tomrodinger/Raspberry_Pi_HAT_RS485/Pictures/view1.jpg

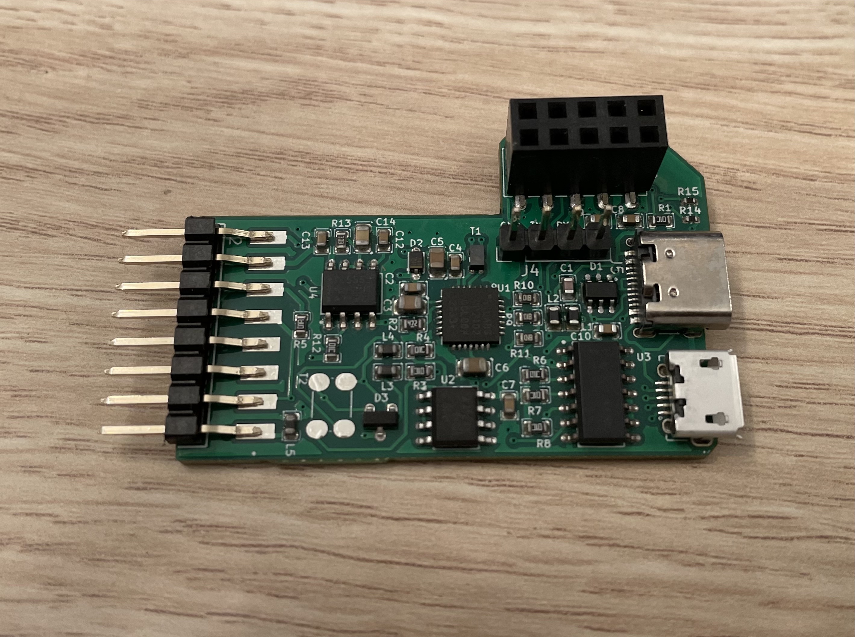
Pictures/view1.jpg
