tomrodinger/Raspberry_Pi_HAT_RS485/README.md

# Raspberry_Pi_HAT_RS485
This is a Raspberry Pi HAT for RS485 communication with external devices and it should fit into any Raspberry Pi like Zero/Zero2W/3/4
