tomrodinger/Raspberry_Pi_HAT_RS485/PCB/1.2/schematic/1.2-index-schTop.pdf

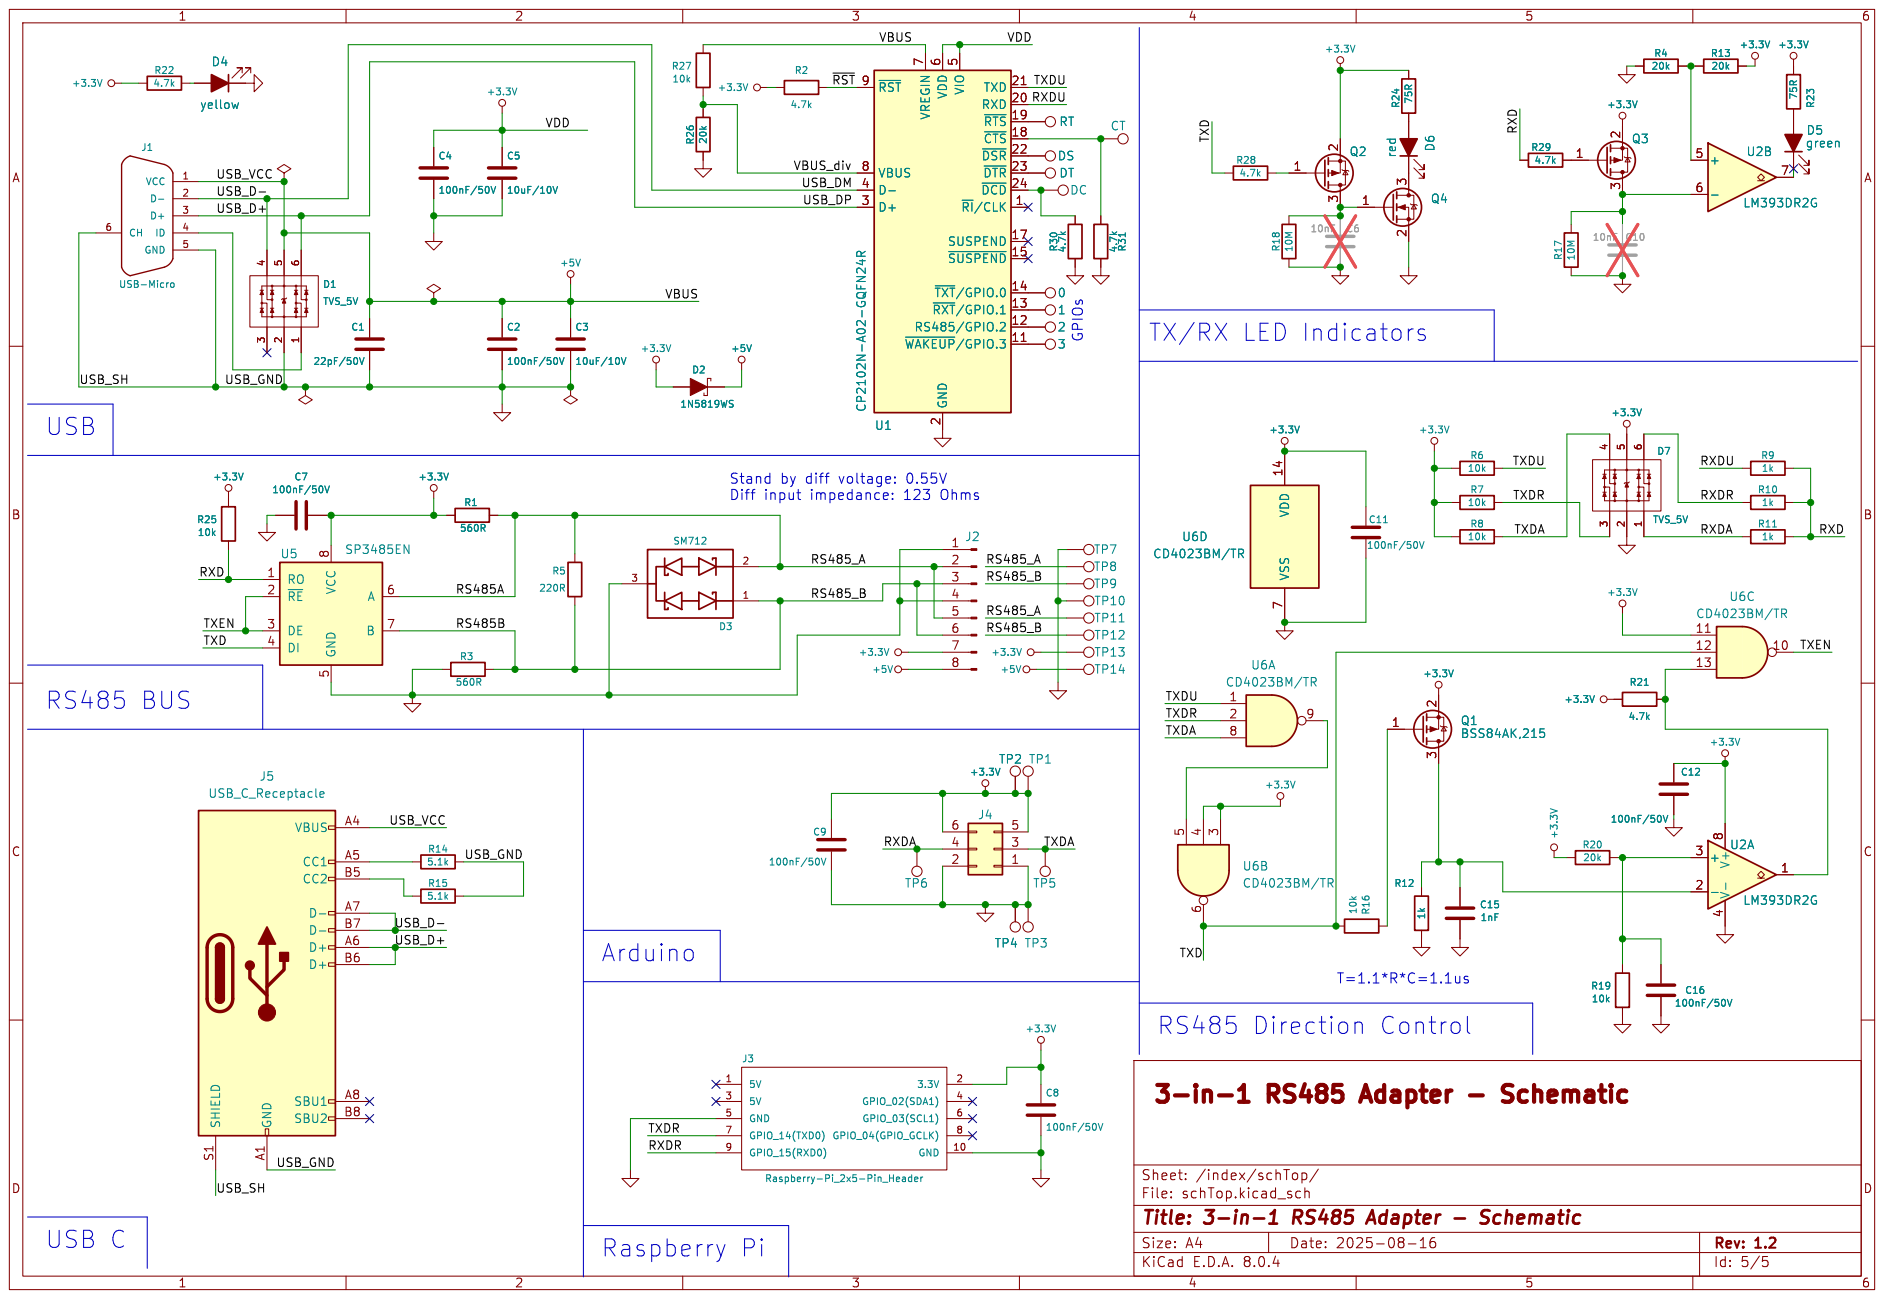
[picture p2: page 1]

2 RXD 20 TXD 21 ~{DSR} 22 ~{DTR} 23 ~{DCD} 24 D+ 3 D- 4 VIO

TX/RX LED Indicators

File: schTop.kicad_sch Sheet: /index/schTop/
