tomrodinger/Raspberry_Pi_HAT_RS485/PCB/1.1/schematic/1.1-index-schTop.pdf

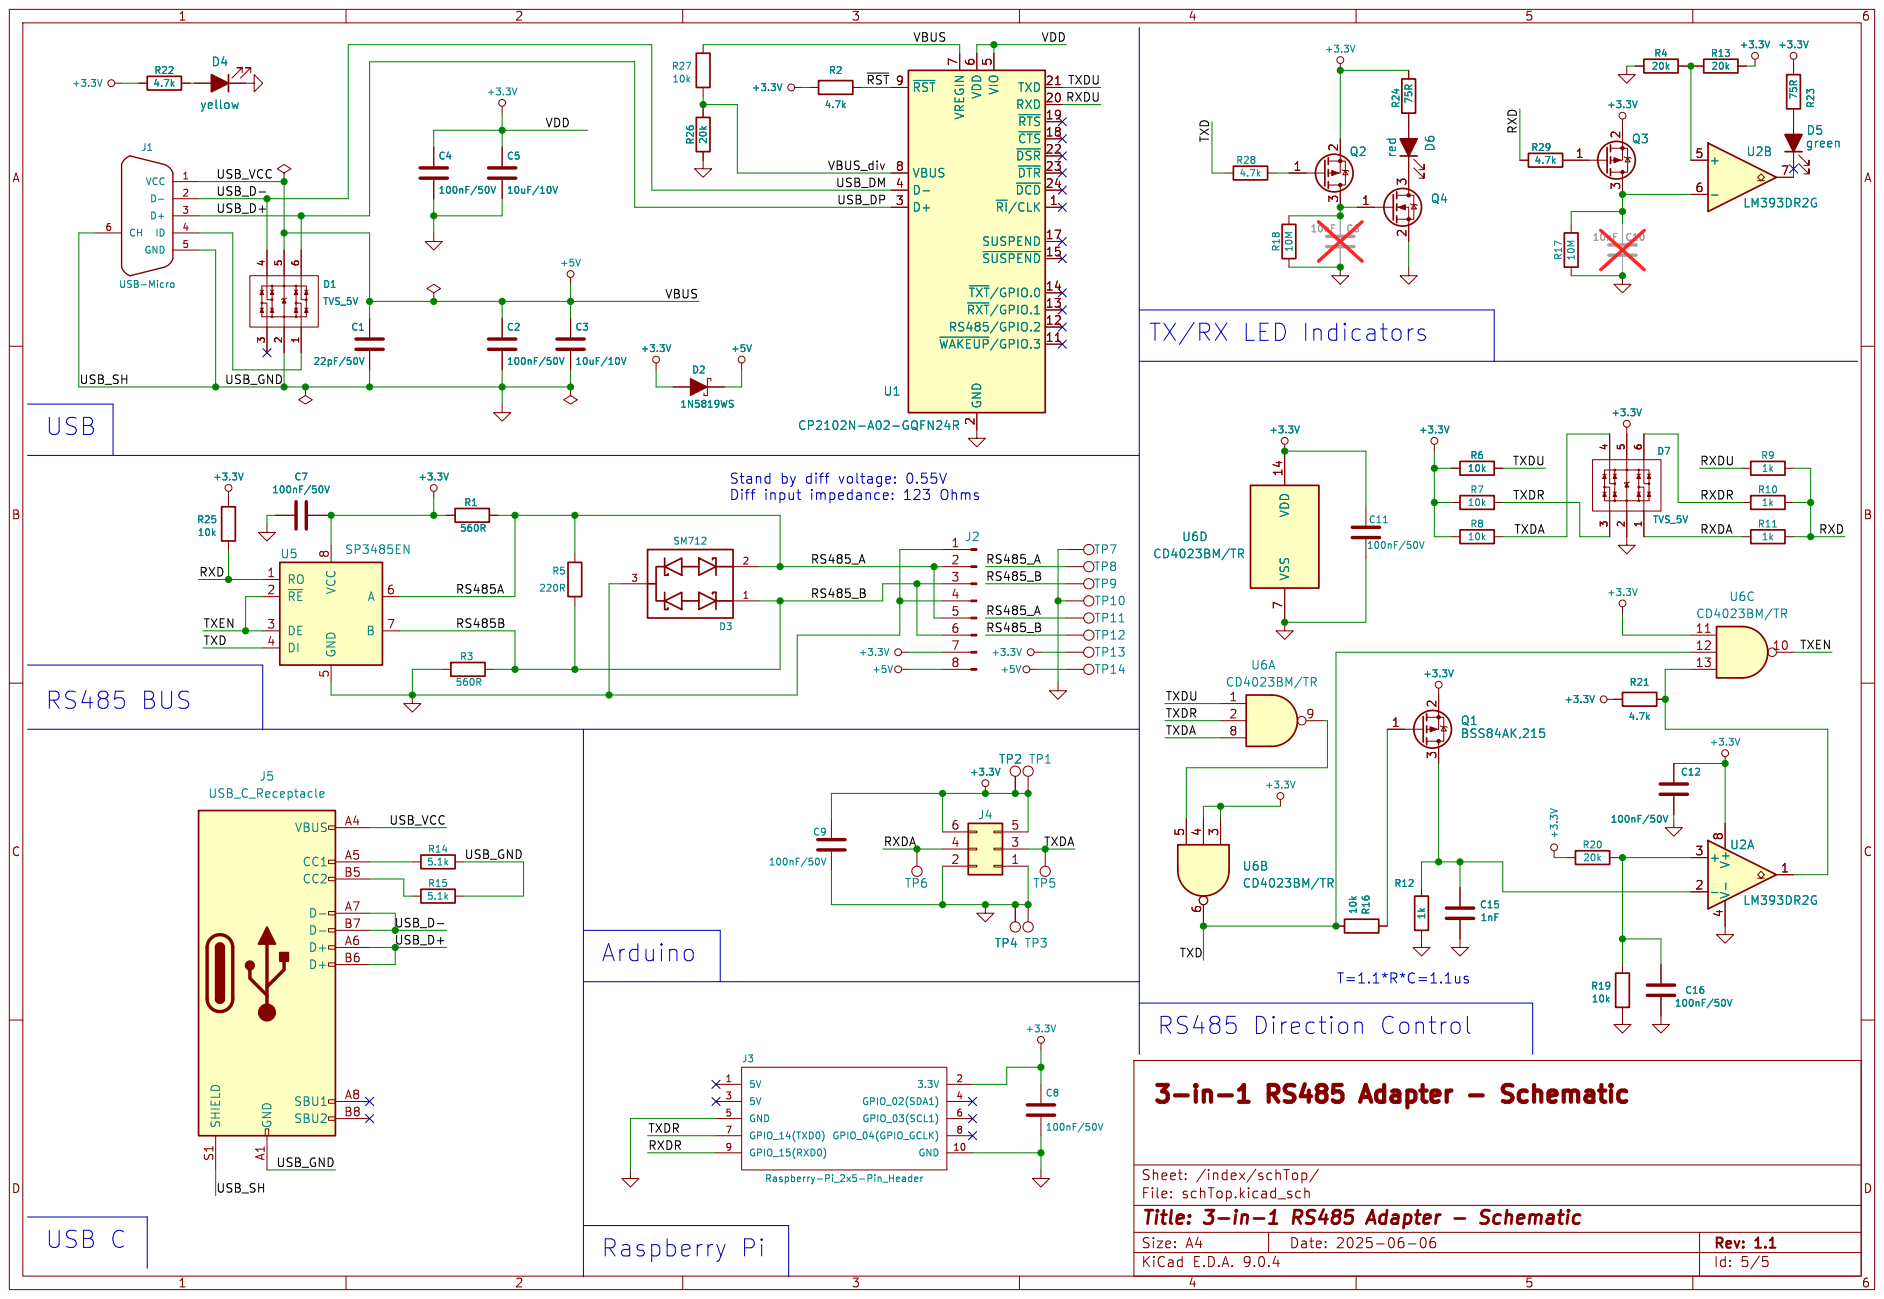
[picture p3: page 1]

5 TXD 21 RXD 20 ~{RTS} 19 ~{CTS} 18 ~{DSR} 22 ~{DTR} 23 ~{DCD} 24 ~{RI}/CLK1 SUSPEND 17 ~{SUSPEND}15 ~{TXT}/GPIO.014 ~{RXT}/GPIO.113 RS485/GPIO.2 12 ~{WAKEUP}/GPIO.311 U1 CP2102N-A02-GQFN24R

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
