tomrodinger/Raspberry_Pi_HAT_RS485/PCB/V5/schematic/sch-uw-rs485_hat-V5-18-06-23.pdf

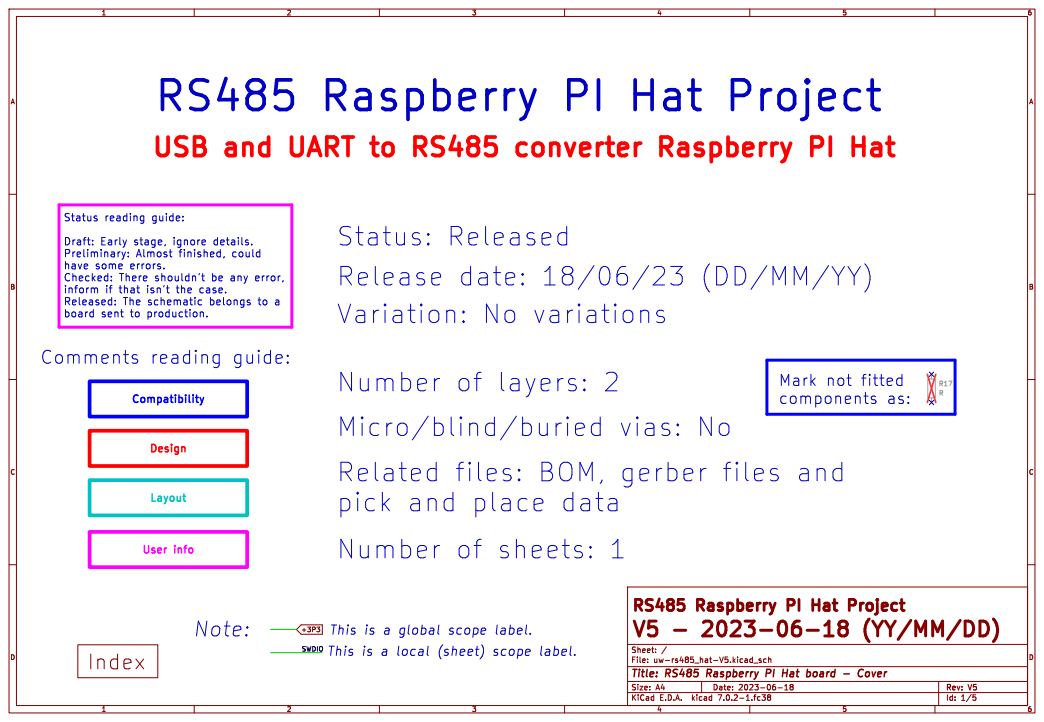
[picture p4: page 1]

Number of layers: 2
Related files: BOM, gerber files and
pick and place data
Number of sheets: 1

RS485 Raspberry PI Hat Project

This is a local (sheet) scope label.

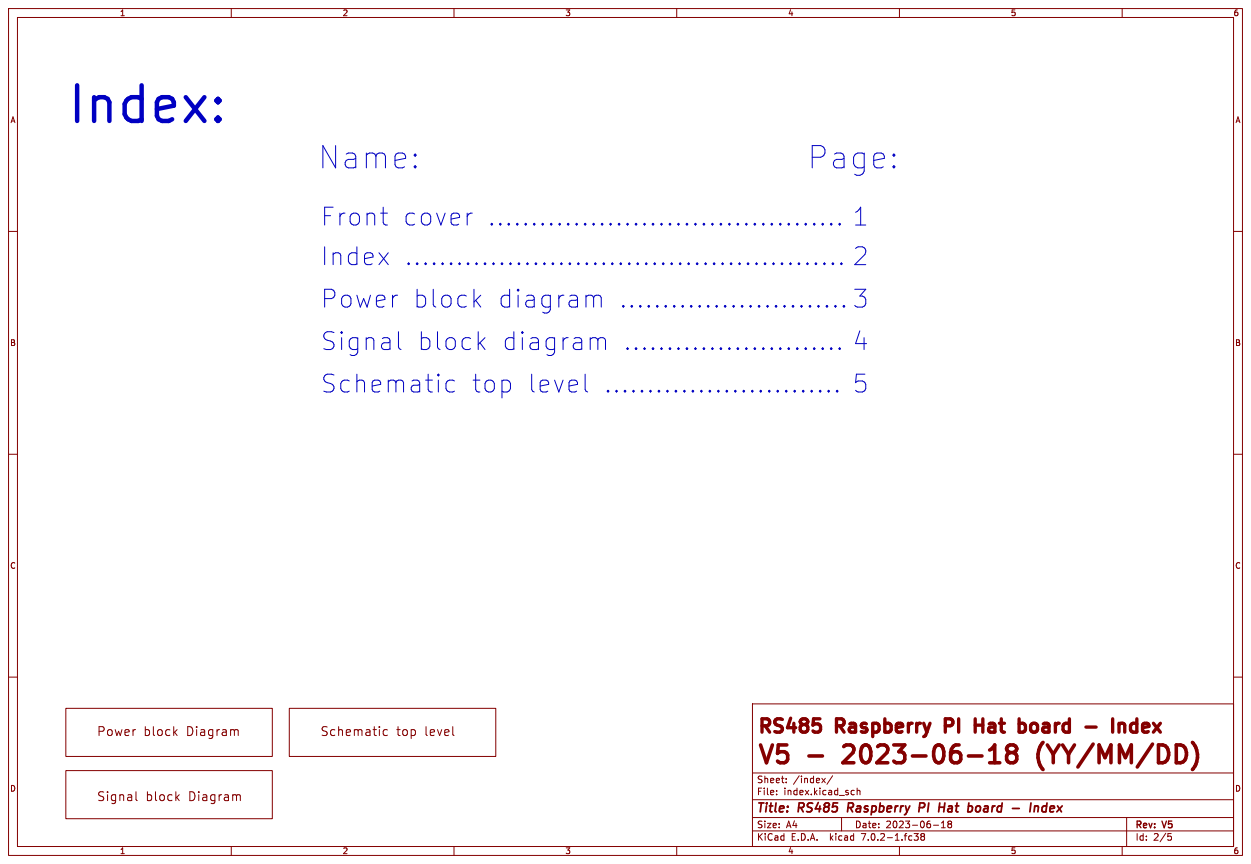
[picture p5: page 2]

Id: 2/5 Title: RS485 Raspberry PI Hat board - Index

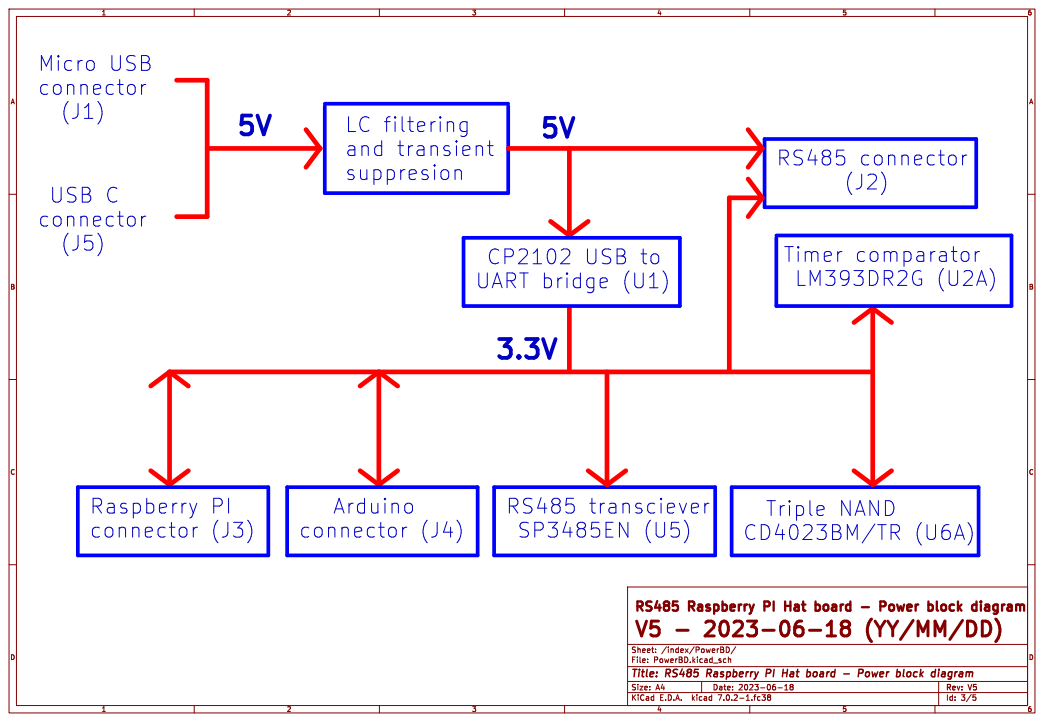
[picture p6: page 3]

Id: 3/5 Title: RS485 Raspberry PI Hat board - Power block diagram

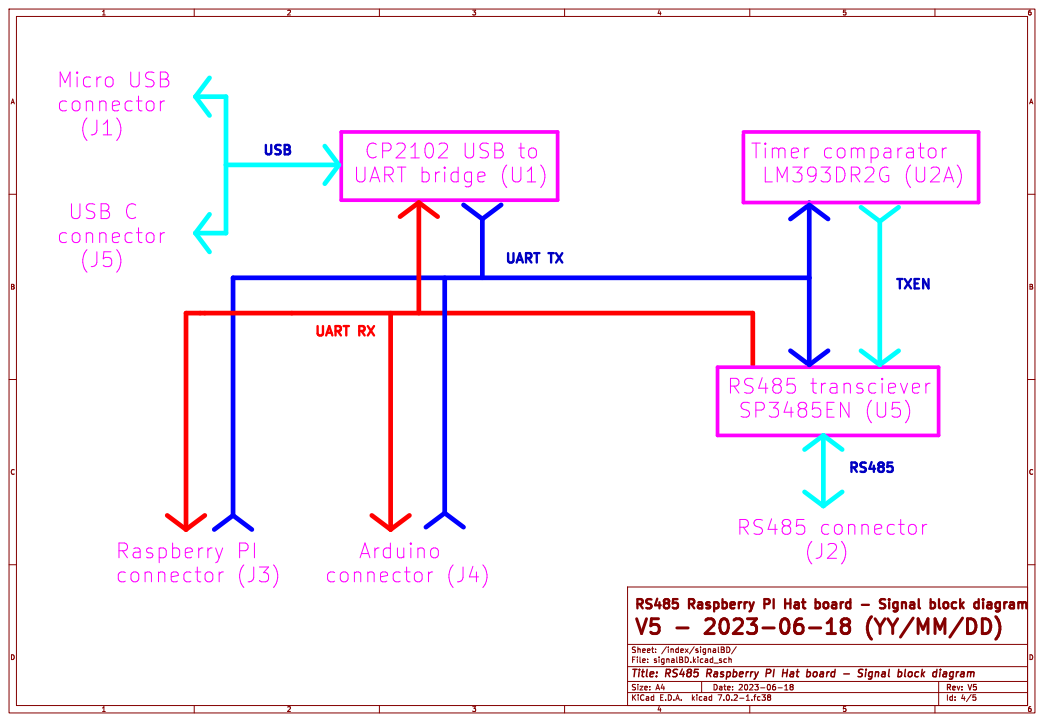
[picture p7: page 4]

File: signalBD.kicad_sch Sheet: /index/signalBD/
Id: 4/5 Title: RS485 Raspberry PI Hat board - Signal block diagram

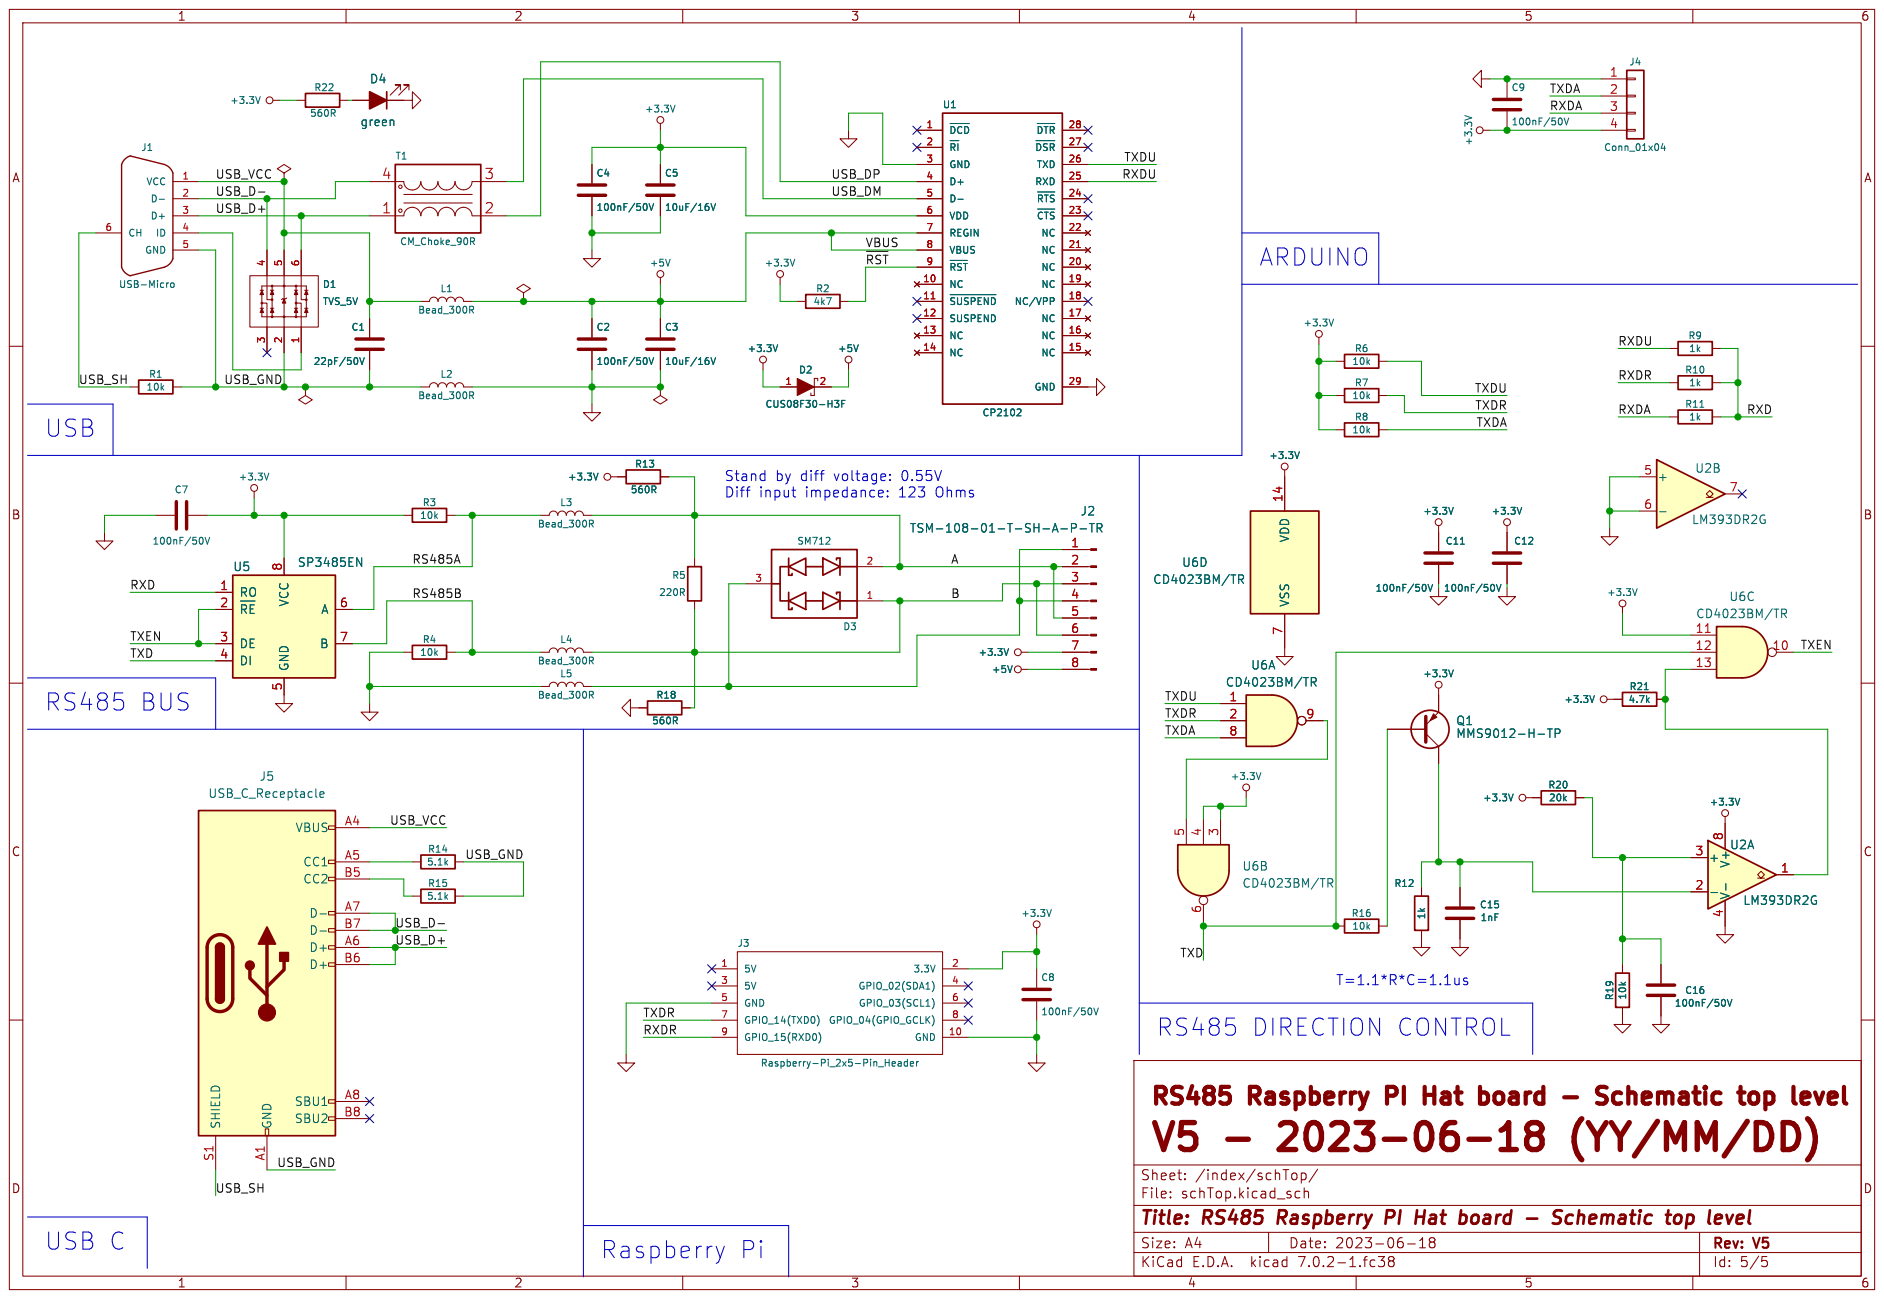
[picture p8: page 5]

6 D1 TVS_5V RO 1 ~{RE} 2 DE 3 DI 4 GND

RS485 Raspberry PI Hat board - Schematic top level

Id: 5/5 Title: RS485 Raspberry PI Hat board - Schematic top level File: schTop.kicad_sch Sheet: /index/schTop/
