tomrodinger/Raspberry_Pi_HAT_RS485/PCB/V4/schematic.pdf

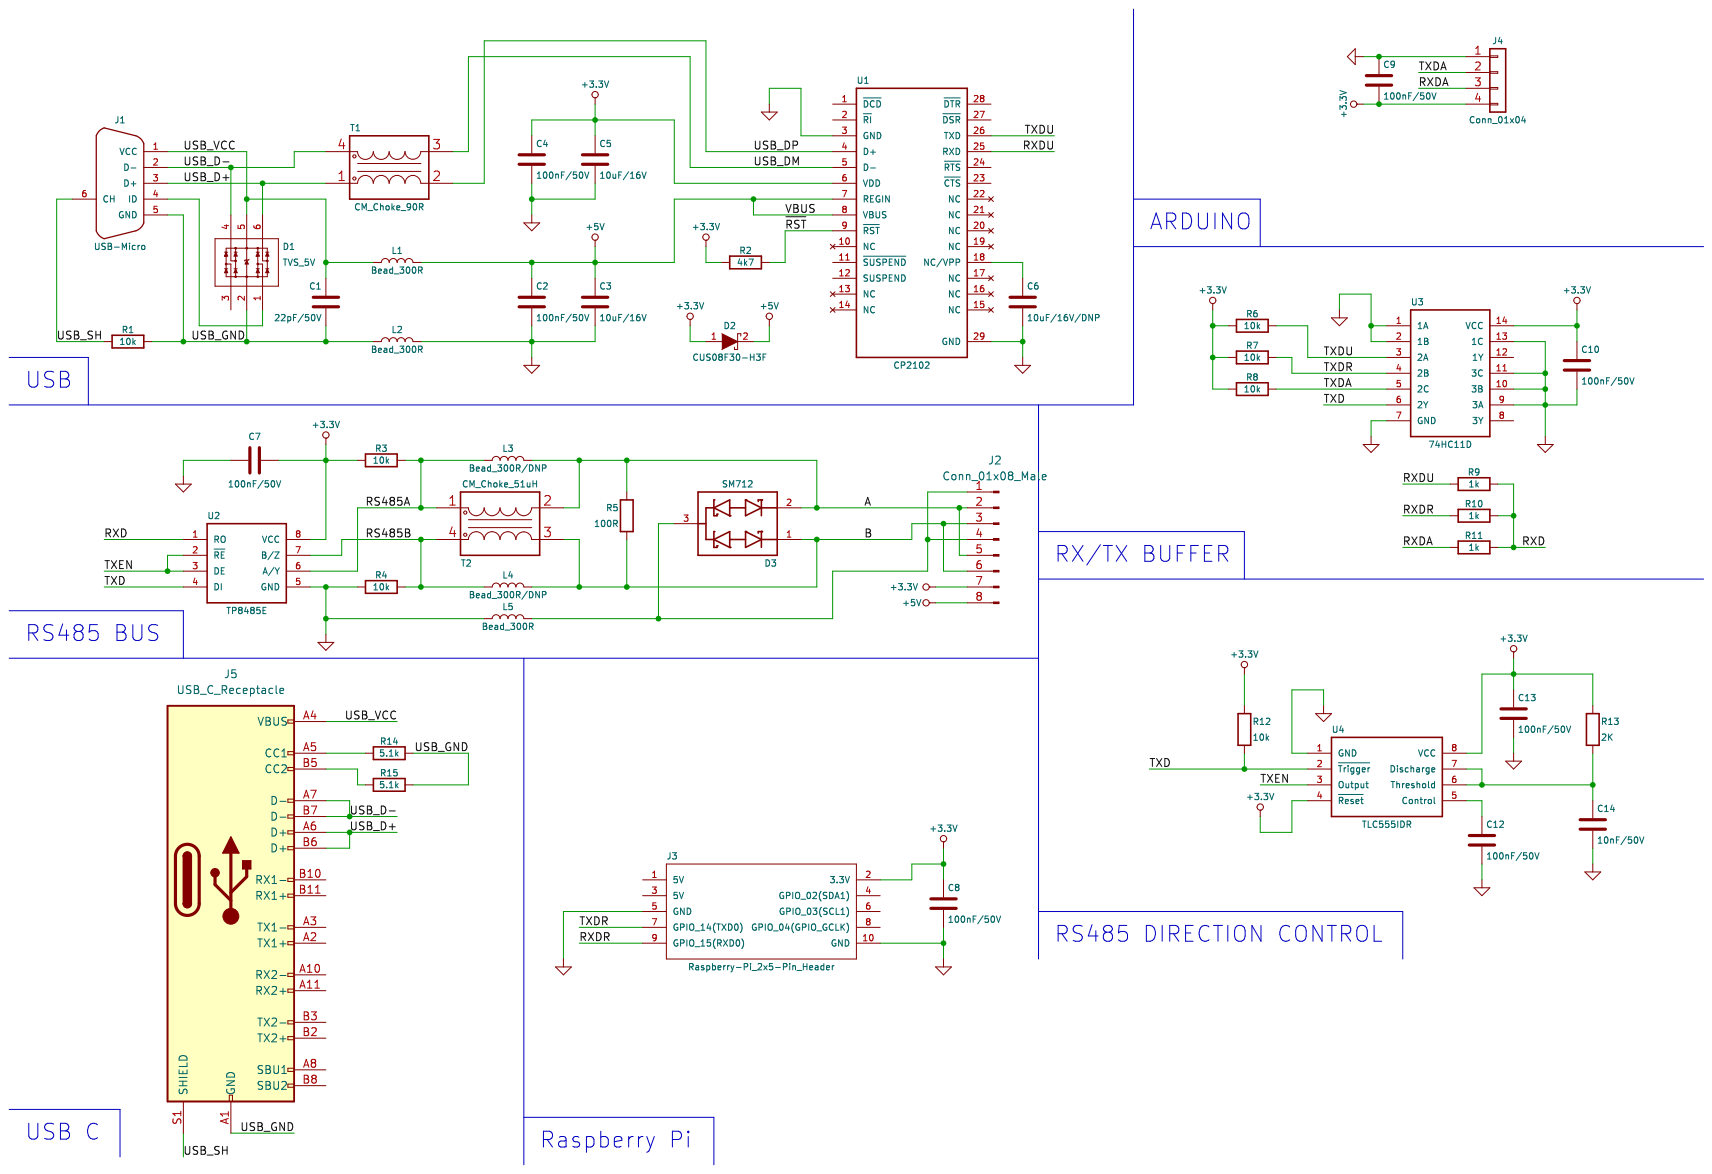
[picture p9: page 1]
