tomrodinger/Raspberry_Pi_HAT_RS485/PCB/V9/V9.kicad_pcb

## KiCad design PCB/V9/V9.kicad_pcb (2025-10-18)

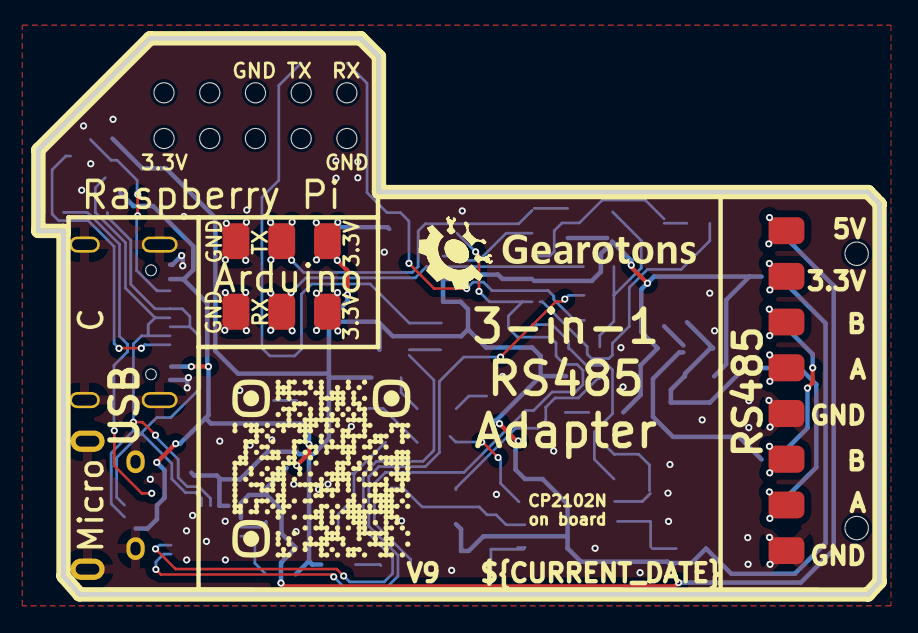
[picture p10: board V9.kicad_pcb from above]

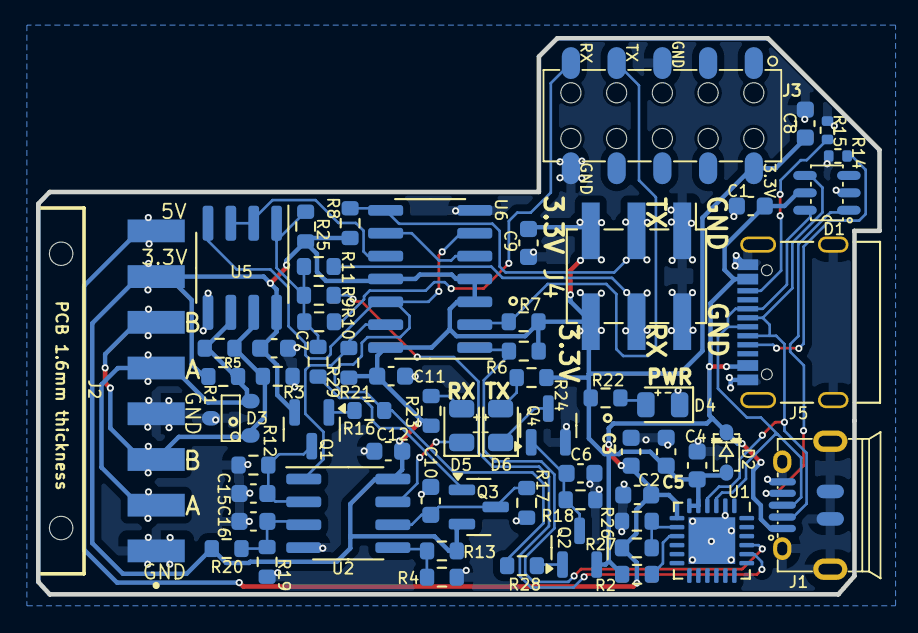
[picture p11: board V9.kicad_pcb from below]

Board: 2 copper layers, 46.7 x 30.9 mm, 76 parts (62 on the bottom side), 35 nets.

Parts:
C1: 22pF/50V; C_0603_1608Metric
C2, C4, C7, C8, C9, C11, C12, C16: 100nF/50V; C_0603_1608Metric
C3, C5: 10uF/10V; C_0603_1608Metric
C6, C10: 10nF; C_0603_1608Metric
C15: 1nF; C_0603_1608Metric
D1: TVS_5V; SOT23-6L
D2: 1N5819WS; SOD323
D3: SM712; SOT23-3
D4: yellow; LED_0805_2012Metric
D5: green; LED_0805_2012Metric
D6: red; LED_0805_2012Metric
J1: USB-Micro; usb-MicroXNJ
J2: TSM-108-01-T-SH-A-P-TR; SAMTEC_TSM-108-01-T-SH-A-P-TR_hole1.5mm
J3: Raspberry-Pi_2x5-Pin_Header; con-WR-PHD-61031021821
J4: Conn_02x03_Odd_Even; PinHeader_2x03_P2.54mm_Vertical_SMD
J5: USB_C_Receptacle; USB_C_Receptacle_Palconn_UTC16-G
Q1, Q2, Q3: BSS84AK,215; SOT-23
Q4: Q_NMOS_GSD; SOT-23
R1, R3: 560R; R_0603_1608Metric
R2, R21, R28, R29: 4.7k; R_0603_1608Metric
R4, R13, R20, R26: 20k; R_0603_1608Metric
R5: 220R; R_0603_1608Metric
R6, R7, R8, R16, R19, R22, R25, R27: 10k; R_0603_1608Metric
R9, R10, R11, R12: 1k; R_0603_1608Metric
R14, R15: 5.1k; R_0402_1005Metric
R17, R18: 10M; R_0603_1608Metric
R23, R24: 75R; R_0603_1608Metric
TP1, TP2, TP3, TP4, TP5, TP6, TP7, TP8, TP9, TP10, TP11, TP12, TP13, TP14: TestPoint; testpoint_no_border
U1: CP2102N-A02-GQFN24R; QFN-24-1EP_4x4mm_P0.5mm_EP2.6x2.6mm
U2: LM393DR2G; SOIC-8_3.9x4.9mm_P1.27mm
U5: SP3485EN; SOIC-8_3.9x4.9mm_P1.27mm
U6: CD4023BM/TR; SOIC-14_3.9x8.7mm_P1.27mm

Connections:
+3.3V: C4.1, C5.1, C7.2, C8.1, C9.2, C11.2, C12.2, D2.1 (A), J2.7, J3.2 (3.3V), J4.5, J4.6, Q1.2 (S), Q2.2 (S), Q3.2 (S), R1.1, R2.2, R6.1, R7.1, R8.1, R13.2, R20.1, R21.2, R22.1, R23.1, R24.1, R25.2, TP1.1, TP2.1, TP13.1, U1.5 (VIO), U1.6 (VDD), U2.8 (V+), U5.8 (VCC), U6.3, U6.4, U6.11, U6.14 (VDD)
+5V: C1.1, C2.1, C3.1, D1.5 (VDD), D2.2 (K), J1.1 (VCC), J2.8, J5.A4 (VBUS), J5.A9 (VBUS), J5.B4 (VBUS), J5.B9 (VBUS), R27.2, TP14.1, U1.7 (VREGIN)
/index/schTop/RS485A: D3.2 (cathode), J2.2, J2.5, R1.2, R5.1, TP8.1, TP11.1, U5.6 (A)
/index/schTop/RS485B: D3.1 (Anode), J2.3, J2.6, R3.2, R5.2, TP9.1, TP12.1, U5.7 (B)
/index/schTop/RXD: R9.2, R10.2, R11.2, R25.1, R29.2, U5.1 (RO)
/index/schTop/RXDA: J4.4, R11.1, TP6.1
/index/schTop/RXDR: J3.9 (GPIO_15(RXD0)), R10.1
/index/schTop/RXDU: R9.1, U1.20 (RXD)
/index/schTop/TXD: R16.1, R28.2, U5.4 (DI), U6.6, U6.12
/index/schTop/TXDA: J4.3, R8.2, TP5.1, U6.8
/index/schTop/TXDR: J3.7 (GPIO_14(TXD0)), R7.2, U6.2
/index/schTop/TXDU: R6.2, U1.21 (TXD), U6.1
/index/schTop/TXEN: U5.2 (~RE), U5.3 (DE), U6.10
/index/schTop/USB_D+: D1.6 (IO4), J1.3 (D+), J5.A6 (D+), J5.B6 (D+), U1.3 (D+)
/index/schTop/USB_D-: D1.4 (IO3), J1.2 (D-), J5.A7 (D-), J5.B7 (D-), U1.4 (D-)
/index/schTop/VBUS_div: R26.2, R27.1, U1.8 (VBUS)
/index/schTop/~RST: R2.1, U1.9 (~RST)
GND: C1.2, C2.2, C3.2, C4.2, C5.2, C6.1, C7.1, C8.2, C9.1, C10.1, C11.1, C12.1, C15.1, C16.1, D1.2 (GND), D3.3 (AK), D4.1 (K), J1.5 (GND), J1.6 (CH), J2.1, J2.4, J3.5 (GND), J3.10 (GND), J4.1, J4.2, J5.A1 (GND), J5.A12 (GND), J5.B1 (GND), J5.B12 (GND), J5.S1 (SHIELD), Q4.2 (S), R3.1, R4.1, R12.1, R14.2, R15.2, R17.1, R18.1, R19.1, R26.1, TP3.1, TP4.1, TP7.1, TP10.1, U1.2 (GND), U1.25 (GND), U2.4 (V-), U5.5 (GND), U6.7 (VSS)
unnamed: D1.1 (IO1), J1.4 (ID)
unnamed: D4.2 (A), R22.2
unnamed: D5.2 (A), R23.2
unnamed: D6.2 (A), R24.2
unnamed: D6.1 (K), Q4.3 (D)
unnamed: J5.A5 (CC1), R14.1
unnamed: J5.B5 (CC2), R15.1
unnamed: C15.2, Q1.3 (D), R12.2, U2.2 (-)
unnamed: Q1.1 (G), R16.2
unnamed: C6.2, Q2.3 (D), Q4.1 (G), R18.2
unnamed: Q2.1 (G), R28.1
unnamed: C10.2, Q3.3 (D), R17.2, U2.6 (-)
unnamed: Q3.1 (G), R29.1
unnamed: R21.1, U2.1, U6.13
unnamed: C16.2, R19.2, R20.2, U2.3 (+)
unnamed: R4.2, R13.1, U2.5 (+)
unnamed: U6.5, U6.9
