tomrodinger/Raspberry_Pi_HAT_RS485/(commit log)

2023-06-01 Organising folders. Adding schematic Adding older V3 PCB Adding PRODUCT_DATA.yaml
    [uw-rs485_hat-B_Mask.gbs, uw-rs485_hat-B_Paste.gbp, uw-rs485_hat-B_Silkscreen.gbo, uw-rs485_hat-Back.gbl, uw-rs485_hat-Edge_Cuts.gm1, uw-rs485_hat-F_Mask.gts, uw-rs485_hat-F_Paste.gtp, uw-rs485_hat-F_Silkscreen.gto]
2023-06-11 Cleaning up some PCB files that should not be in the root folder.
    [uw-rs485_hat.kicad_sch]
2023-06-19 Adding V5 of the PCB. Here we changed the logic for enabling the DE (drive enable) line on the RS480 tranceiver because previous version had flawed logic and did not work 100% correctly.
    [BOM-uw-rs485_hat-V5-18-06-23.csv, PCBsubmisionChecklist-uw-rs485_hat-V5-18-06-23.xlsx, PP-uw-rs485_hat-V5-18-06-23.csv, PowerBD.kicad_sch, beforePCBchecklist-uw-rs485_hat-V5-18-06-23.xlsx, index.kicad_sch, schTop.kicad_sch, signalBD.kicad_sch]
2025-10-18 Adding PCB files for V9, 1.1, and 1.2 Modifying the PRODUCT_DATA.yaml file to include the new versions of the product Adding more up to date pictures Adding a .gitignore Adding a test program that se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
    [1.1.kicad_pcb, 1.1.kicad_sch, 1.2.kicad_pcb, 1.2.kicad_sch, PowerBD.kicad_sch, RS485_adapter_version_1.1_bom.csv, V9.kicad_pcb, V9.kicad_sch]
2025-10-18 Attempting to fix a link to the schematic for V9, 1.1, 1.2
2025-10-18 Another attempt to fix the link to the schematics
2025-11-18 Updating the PCB to remove the test points from the BOM and also to substitute the raspberry pi header part number because the previous one was out of stock in JLCPCB.
    [RS485_adapter_version_1.1_bom.csv, bom.csv, schTop.kicad_sch]
